kalpeshpatil33/Sumo_Robot/Report/First_Page.tex

\thispagestyle{empty}

\begin{center}

%\begin{figure}[h!]
%\begin{center}
%\includegraphics[scale=1]{uni_crest.png}
%\end{center}
%\end{figure}

\vspace*{.5cm}

\title{ \bfseries Sumo Robot \\ Report}
\author{Kalpesh Patil \\ Kanishke Gamagedara\\ {\normalsize kanishkegb@gwu.edu}\\{\normalsize Fall 2016}}

\vspace{10 mm}
 {\bf \color{MidnightBlue} {\Huge Sumo Robot } \vspace{4mm} \hline  \vspace{4mm} {\Huge Report}}\\

\vspace*{6cm}

{\large This is the project report for the robot ``Interpreter'' made for the class MAE 6194 }

\vspace*{5cm}

{\large Kalpesh Patil \\ {\normalsize kalpeshpatil33@gwu.edu }\\ \vspace*{5mm} Kanishke Gamagedara}\\ 
{\normalsize kanishkegb@gwu.edu}\\\vspace*{5mm}{\large Spring 2017}

\vspace*{3cm}

{\LARGE 
The George Washington University}

\end{center}
