kalpeshpatil33/Sumo_Robot/Report/structure.tex

%\usepackage{microtype}
%\usepackage[utf8]{inputenc}
%\usepackage[T1]{fontenc}
%\usepackage{titlesec}
%\usepackage{graphicx}
%\usepackage{enumitem}
%\usepackage{amsthm}
%%\setlist{nolistsep}
%\usepackage{tikz}
%\graphicspath{{images/}}
%
%\usepackage[utf8]{inputenc}
%\usepackage{amsmath}
%\usepackage{amsfonts}
%\usepackage{amssymb}
%\usepackage[left=2cm,right=2cm,top=2cm,bottom=2cm]{geometry}
%%\usepackage{color}
%\usepackage[usenames,dvipsnames]{xcolor}
%\usepackage{sectsty}
%\usepackage{framed}
%%\usepackage{tikz}
%
%% Font Settings
%\usepackage{avant}
%\usepackage{fourier} 
%\usepackage{charter}
%
%\theoremstyle{definition}
%\newtheorem{definition}{Definition}[section]
%\newtheorem{example}{Ex.}[section]
%\newtheorem{theorem}{Theorem}[section]
%

\usepackage{graphicx}
\graphicspath{{images/}} %image directory

\usepackage{amsmath}
\usepackage{amsfonts}
\usepackage{amssymb}
\usepackage{graphicx}
\usepackage{url}
\usepackage[top=25mm, bottom=25mm, left=30mm, right=25mm]{geometry}
\setlength{\parindent}{0cm} % first para - no indent
\usepackage{titlesec}
\usepackage{setspace}
\usepackage[nottoc]{tocbibind}
\usepackage{listings}
%\usepackage[table]{xcolor}
\usepackage{multirow}
\usepackage{pdflscape}
\usepackage{color}
\usepackage[usenames,dvipsnames]{xcolor}
\usepackage{fancyhdr}
\newtheorem{mydef}{Example}
\titlespacing*{\chapter}{0pt}{0pt}{20pt}
\usepackage{microtype}
\usepackage[toc,page]{appendix}

%\setlist{nolistsep}

% Font settings
\usepackage{avant}
\usepackage{fourier} 
\usepackage{charter}

% Header settings
%\titleformat{\chapter}{\Large\bfseries}{Chapter \thechapter }{14pt}{\Large}
%\titleformat{\chapter}{\Large\bfseries}{\thechapter }{14pt}{\Large}
\titleformat{\section}{\large\bfseries}{{\color{MidnightBlue}\thesection }}{13pt}{\color{MidnightBlue}\large}
\titleformat{\subsection}{\normalsize\bfseries}{ \color{NavyBlue}\thesubsection }{12pt}{\color{NavyBlue}\normalsize}
\titleformat{\paragraph}{\normalsize\bfseries}{ \thesection }{12pt}{\large}

% Itemize - remove exrea linespace
\newlength{\wideitemsep}
\setlength{\wideitemsep}{.5\itemsep}
\addtolength{\wideitemsep}{-7pt}
\let\olditem\item
\renewcommand{\item}{\setlength{\itemsep}{\wideitemsep}\olditem}

% Header and footer
\fancypagestyle{plain}{
\fancyhf{}
\renewcommand{\headrulewidth}{0pt}
\renewcommand{\footrulewidth}{0pt}
\fancyfoot[LE,RO]{\scriptsize{ \thepage} }
%\fancyfoot[RE,LO]{\small ODROID XU4 - Documentation}
%\fancyhead[RO,LE]{\scriptsize{FDCL Document}}
}

\definecolor{maroon}{RGB}{173,34,49}
\definecolor{shadecolor}{RGB}{233,244,255}
\definecolor{exframecolor}{RGB}{255,255,255}
\definecolor{exshadecolor}{RGB}{250,252,252}    

\newenvironment{exframe}{
\def\FrameCommand{\fboxrule=\FrameRule\fboxsep=\FrameSep \fcolorbox{exframecolor}{exshadecolor}}
\MakeFramed {\FrameRestore}}
{\endMakeFramed}

% For hyperlinks
\usepackage{hyperref}
\hypersetup{
    colorlinks,
    linkcolor={black!80!black},
    citecolor={blue!50!black},
    urlcolor={blue!80!black}
}

\usepackage{cleveref}  % automatic reference formatting (load AFTER hyperref)
\pagestyle{plain}
