kalpeshpatil33/Sumo_Robot/Report/images/placeholder.png

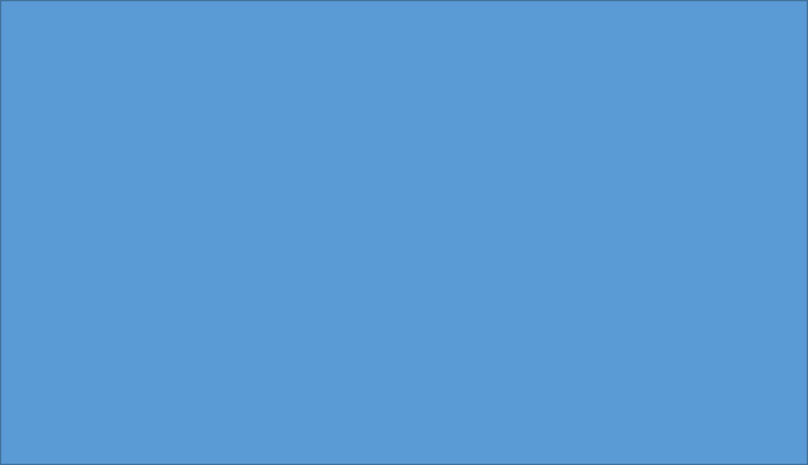
Report/images/placeholder.png
