kalpeshpatil33/Sumo_Robot/Report/images/structure.jpg

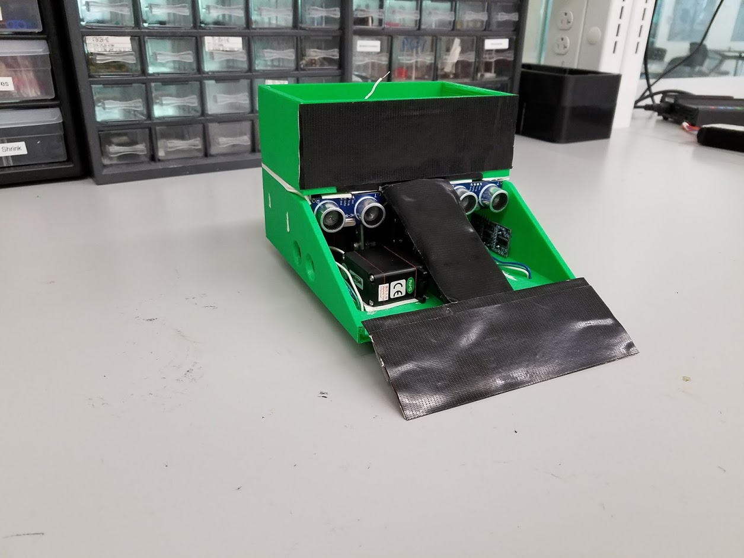
Report/images/structure.jpg
