kalpeshpatil33/Sumo_Robot/3dPrint/body.SLDPRT

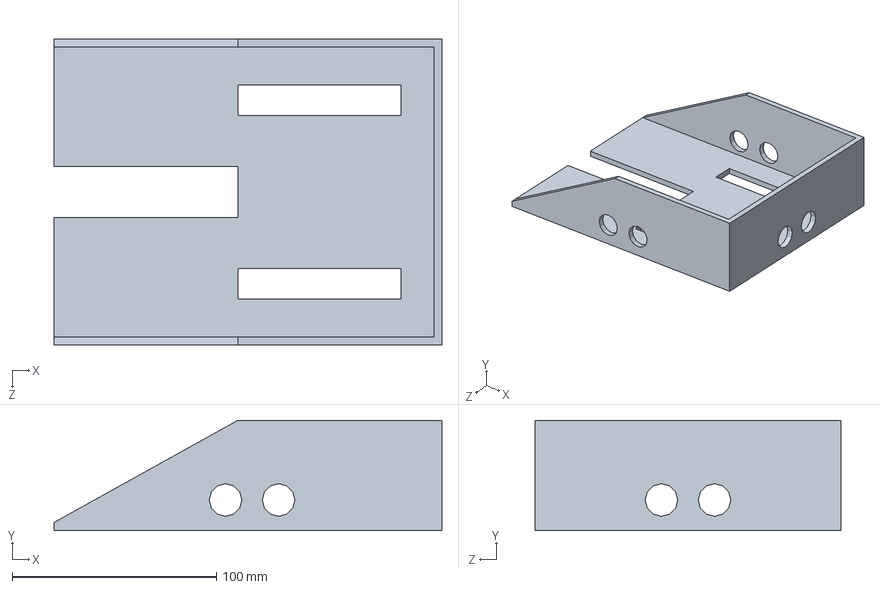
[picture p16: CAD file, 2017-04-25]
3dPrint/body.SLDPRT
190.0 x 54.0 x 150.0 mm
