kalpeshpatil33/Sumo_Robot/3dPrint/datapackage.SLDPRT

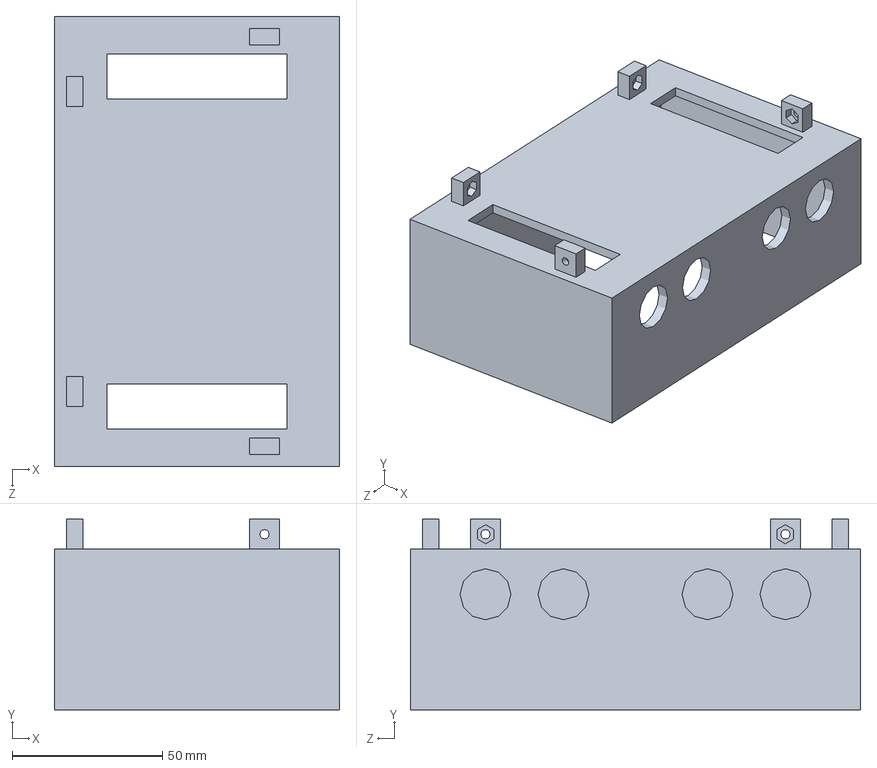
[picture p17: CAD file, 2017-04-25]
3dPrint/datapackage.SLDPRT
95.0 x 63.5 x 150.0 mm
