kalpeshpatil33/Sumo_Robot/3dPrint/cover.SLDPRT

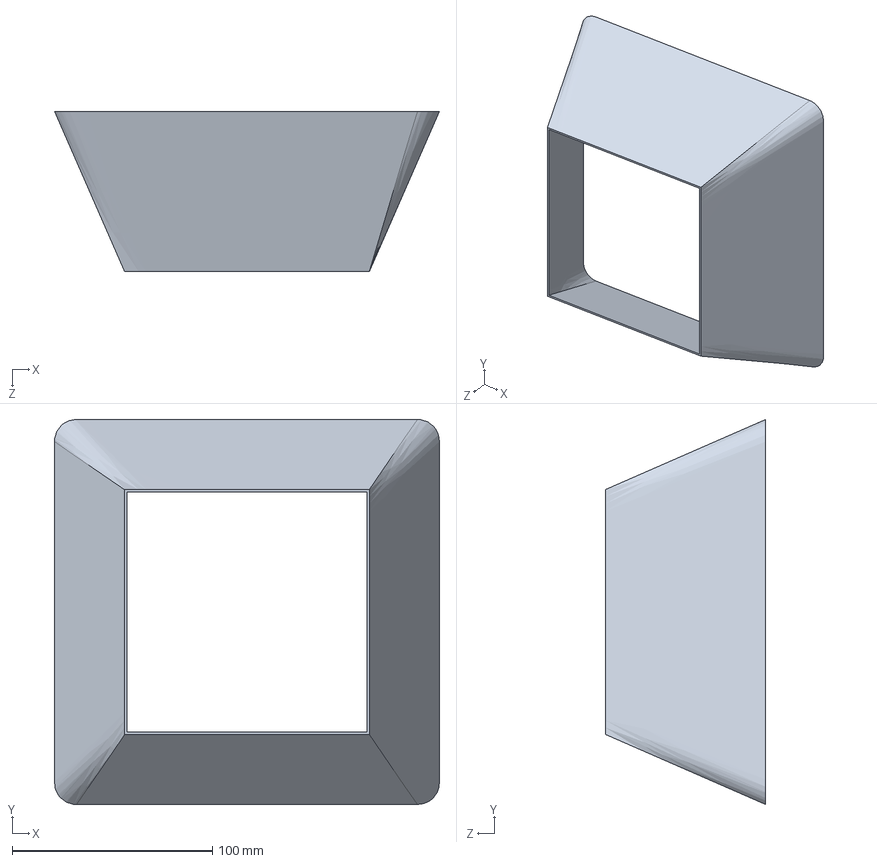
[picture p18: CAD file, 2017-04-17]
3dPrint/cover.SLDPRT
192.2 x 192.2 x 80.0 mm
