kalpeshpatil33/Sumo_Robot/3dPrint/Chassis.SLDPRT

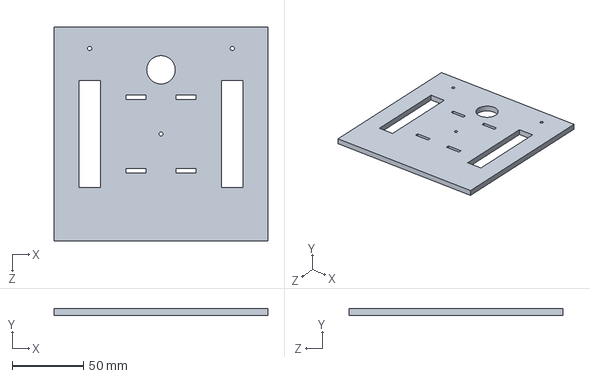
[picture p19: CAD file, 2017-04-05]
3dPrint/Chassis.SLDPRT
150.0 x 5.00 x 150.0 mm
