kalpeshpatil33/Sumo_Robot/(list of files, cad)

Other CAD files:
3dPrint/Chassis.STL
3dPrint/body.STL
3dPrint/datapackage.STL
