kalpeshpatil33/Sumo_Robot/Report/images/flowchart.pdf

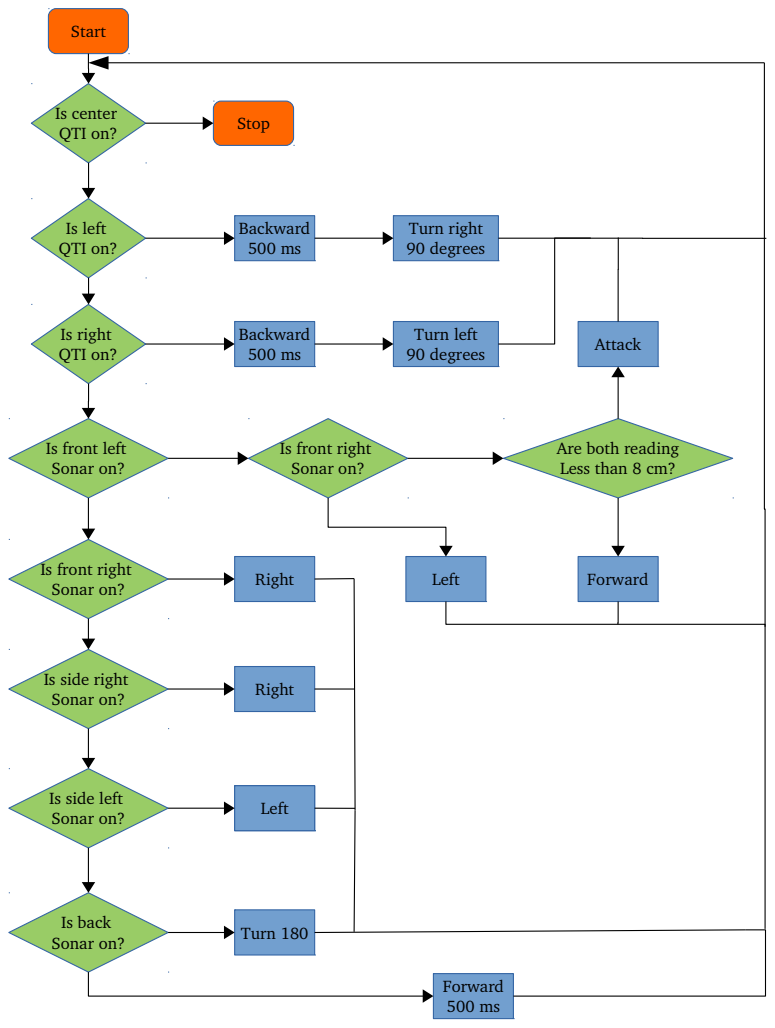
[picture p20: page 1]
Is center QTI on?; Start; Stop; Sonar on?; Right; Is back Sonar on?; Attack; Is left QTI on?; Is right QTI on?; Backward 500 ms; Turn right 90 degrees; Turn left 90 degrees; Left; Turn 180; Forward 500 ms

Is front left
Sonar on?

Is front right

Are both reading
Less than 8 cm?

Forward Is front right

Is side right

Is side left
