kalpeshpatil33/Sumo_Robot/mileStone_3/mileStone_3/mileStone_3.ino

int flag_Found;
int count = 0;
int left_count = 0;

//********** Wheels Variable **********
#include <Servo.h>
Servo myservo1;
Servo myservo2;
#define HCdistance 60

//********** QTI MIDDLE Variable **********
// BLACK == 1
volatile int MIDDLE_whiteLine;
int MIDDLE_sensorVal;
#define MIDDLE_pinQTIsensor 2

//********** QTI LEFT Variable **********
volatile int LEFT_whiteLine;
int LEFT_sensorVal;
#define LEFT_pinQTIsensor 21

//********** QTI RIGHT Variable **********
volatile int RIGHT_whiteLine;
int RIGHT_sensorVal;
#define RIGHT_pinQTIsensor 20

//********** HC-SR04 FRONT Variable **********
#define FRONT_trigPin 13
#define FRONT_echoPin 12
long FRONT_duration, FRONT_distance;

//********** HC-SR04 BACK Variable **********
#define BACK_trigPin 21
#define BACK_echoPin 22
long BACK_duration, BACK_distance;

//********** HC-SR04 LEFT Variable **********
#define LEFT_trigPin 21
#define LEFT_echoPin 22
long LEFT_duration, LEFT_distance;

//********** HC-SR04 RIGHT Variable **********
#define RIGHT_trigPin 21
#define RIGHT_echoPin 22
long RIGHT_duration, RIGHT_distance;


void goForward()
{
  digitalWrite(22, LOW);
  //Serial.println("Forward");
  myservo1.write(0);
  myservo2.write(190);
}

void goBackward()
{
  digitalWrite(22, LOW);
  //Serial.println("Backward");
  myservo1.write(190);
  myservo2.write(0);
}

void goLeft()
{
  digitalWrite(22, LOW);
  //Serial.println("Left");
  myservo1.write(0);
  myservo2.write(0);
}

void goRight()
{
  digitalWrite(22, LOW);
  //Serial.println("Right");
  myservo1.write(190);
  myservo2.write(190);
}

void goStop()
{
  digitalWrite(22, HIGH);
  //Serial.println("Stop");
  myservo1.write(95);
  myservo2.write(95);
}

void goU()
{
  //Serial.println("U");
  myservo1.write(0);
  myservo2.write(0);
}

void FRONT_HC()
{
  digitalWrite(FRONT_trigPin, LOW);
  digitalWrite(FRONT_trigPin, HIGH);
  delay(100);
  digitalWrite(FRONT_trigPin, LOW);
  FRONT_duration = pulseIn(FRONT_echoPin, HIGH);
  FRONT_distance = (FRONT_duration / 2) / 29.1;
}

void BACK_HC()
{
  digitalWrite(BACK_trigPin, LOW);
  digitalWrite(BACK_trigPin, HIGH);
  digitalWrite(BACK_trigPin, LOW);
  BACK_duration = pulseIn(BACK_echoPin, HIGH);
  BACK_distance = (BACK_duration / 2) / 29.1;
}

void LEFT_HC()
{
  digitalWrite(LEFT_trigPin, LOW);
  digitalWrite(LEFT_trigPin, HIGH);
  digitalWrite(LEFT_trigPin, LOW);
  LEFT_duration = pulseIn(LEFT_echoPin, HIGH);
  LEFT_distance = (LEFT_duration / 2) / 29.1;
}

void RIGHT_HC()
{
  digitalWrite(RIGHT_trigPin, LOW);
  digitalWrite(RIGHT_trigPin, HIGH);
  digitalWrite(RIGHT_trigPin, LOW);
  RIGHT_duration = pulseIn(RIGHT_echoPin, HIGH);
  RIGHT_distance = (RIGHT_duration / 2) / 29.1;
}

void searchBot ()
{
  //Serial.println("Searching");
  FRONT_HC();
  if (FRONT_distance < HCdistance && flag_Found == 0 )
  {
    //Serial.println("Front Detected");
    //Serial.println(FRONT_distance);
    goForward();
    flag_Found = 1;
  }
  //  BACK_HC();
  //  if (BACK_distance < 30 && flag_Found == 0 )
  //  {
  //    goU();
  //    delay(450);
  //    goStop();
  //    flag_Found = 1;
  //  }
  //  else
  //  {
  //    goStop();
  //  }
  //
  //  RIGHT_HC();
  //  if (RIGHT_distance < 30 && flag_Found == 0 )
  //  {
  //    goRight();
  //    delay(450);
  //    goStop();
  //    flag_Found = 1;
  //  }
  //  else
  //  {
  //    goStop();
  //  }
  //
  //  LEFT_HC();
  //  if (LEFT_distance < 30 && flag_Found == 0 )
  //  {
  //    goLeft();
  //    delay(450);
  //    goStop();
  //    flag_Found = 1;
  //  }
  //  else
  //  {
  //    goStop();
  //  }
}

void setup() {

  Serial.begin(115200);

  myservo1.attach(9);  // attaches the servo on pin 9 to the servo object
  myservo2.attach(8);

  pinMode(LEFT_pinQTIsensor, INPUT);
  digitalWrite(LEFT_pinQTIsensor, HIGH);

  pinMode(MIDDLE_pinQTIsensor, INPUT);
  digitalWrite(MIDDLE_pinQTIsensor, HIGH);

  pinMode(RIGHT_pinQTIsensor, INPUT);
  digitalWrite(RIGHT_pinQTIsensor, HIGH);

  attachInterrupt(digitalPinToInterrupt(MIDDLE_pinQTIsensor), MIDDLE_whiteLineISR, LOW);
  //  attachInterrupt(digitalPinToInterrupt(RIGHT_pinQTIsensor), RIGHT_whiteLineISR, LOW);
  //  attachInterrupt(digitalPinToInterrupt(LEFT_pinQTIsensor), LEFT_whiteLineISR, LOW);

  // we need to call this to enable interrupts
  interrupts();
  MIDDLE_whiteLine = 1;

  pinMode(FRONT_trigPin, OUTPUT);
  pinMode(FRONT_echoPin, INPUT);

  flag_Found = 0;

  //Serial.println("Initializing all sensors");
  delay(2000);
}

void MIDDLE_whiteLineISR() {
  goStop();
  //Serial.println(MIDDLE_sensorVal);
  //Serial.println("STOP Interrupt");
  MIDDLE_whiteLine = 0;
}

void RIGHT_whiteLineISR() {
  //  goLeft();
  //  goStop;
  //  goBackward();
  RIGHT_whiteLine = 1;
  //Serial.println("RIGHT Interrupt");
  //  MIDDLE_whiteLine = 1;
}

void LEFT_whiteLineISR() {
  //  goStop;
  //  goBackward();
  //  goRight();
  digitalWrite(22, LOW);
  //Serial.println("Backward");
  myservo1.write(190);
  myservo2.write(0);
  LEFT_whiteLine = 1;
  //Serial.println("LEFT Interrupt");
  //  MIDDLE_whiteLine = 1;
}


void loop()
{
  //Serial.println("Starts reading....");
  MIDDLE_sensorVal = digitalRead(MIDDLE_pinQTIsensor);
  LEFT_sensorVal = digitalRead(LEFT_pinQTIsensor);
  RIGHT_sensorVal = digitalRead(RIGHT_pinQTIsensor);
  //Serial.println("MIDDLE_sensorVal: " + String(MIDDLE_sensorVal));
  //Serial.println("LEFT_sensorVal: " + String(LEFT_sensorVal));
  //Serial.println("RIGHT_sensorVal: " + String(RIGHT_sensorVal));

  //  if (RIGHT_whiteLine == 1) {
  //    //Serial.println("Going back");
  //    //      goStop();
  //    goBackward();
  //    delay(200);
  //    RIGHT_whiteLine = 0;
  //  }
  //
  //  if (LEFT_whiteLine == 1) {
  //    //      goStop();
  //    //Serial.println("Going back");
  //    goBackward();
  //    delay(200);
  //    LEFT_whiteLine = 0;
  //  }
  if (MIDDLE_whiteLine == 1)
  {
    //Serial.println("No White Line");
    if (flag_Found == 0)
    {
      searchBot();
      delay(50);
      count ++;
    }
    if (count == 5)
    {
      goForward();
      delay(100);
      count = 0;
    }

    if (flag_Found == 0)
    {
      if (left_count > 5) {
        goForward();
        delay(20);
        left_count++;
        if (left_count > 9) {
         left_count = 0; 
        }
      }
      else {
        goLeft();
        delay(10);
        left_count++;
      }

    }
    flag_Found = 0;

    if (LEFT_sensorVal == 0 && RIGHT_sensorVal == 1 )
    {
      Serial.println("LEFT Interrupt loop");
      goStop();
      delay(10);
      goBackward();
      delay(1000);
      goRight();
      delay(1000);
      goForward();
      delay(500);
      MIDDLE_whiteLine = 1;
    }

    if (RIGHT_sensorVal == 0 && LEFT_sensorVal == 1)
    {
      Serial.println("RIGHT Interrupt loop");
      goStop();
      delay(10);
      goBackward();
      delay(1000);
      goLeft();
      delay(1000);
      goForward();
      delay(500);
      MIDDLE_whiteLine = 1;
    }

    if (RIGHT_sensorVal == 0 && LEFT_sensorVal == 0)
    {
      ////Serial.println("LEFT RIGHT Interrupt loop");
      goStop();
      delay(100);
      goU();
      delay(50);
      goStop();
      delay(100);
      goForward();
      delay(100);
    }
  }
}
