kalpeshpatil33/Sumo_Robot/test_HC-SR04/test_HC-SR04/test_HC-SR04.ino

#define trigPin 13
#define echoPin 12
long duration, distance;

void setup() {
  Serial.begin (9600);
  pinMode(trigPin, OUTPUT);
  pinMode(echoPin, INPUT);
}

void loop() {

  digitalWrite(trigPin, LOW); 
  digitalWrite(trigPin, HIGH);
delay(100);
  digitalWrite(trigPin, LOW);
  duration = pulseIn(echoPin, HIGH);
  distance = (duration / 2) / 29.1;
  Serial.println(String(duration) + "  " + String(distance));

}
