kalpeshpatil33/Sumo_Robot/(commit log)

2017-04-05 Chassis File Added
    [Chassis.SLDPRT]
2017-04-05 Final motorTest_QTI (Milestone_1)
2017-04-05 .thing file update
    [Chassis.STL]
2017-04-17 milestone_2 updated
    [cover.SLDPRT]
2017-04-20 milestone 3 started
    [body.SLDPRT, body.STL]
2017-04-25 milestone 3 updating
    [body.SLDPRT, datapackage.SLDPRT, datapackage.STL]
2017-05-07 sonars working with left right turns
2017-05-08 motors+qti working
2017-05-08 changed qti interrupts to flags
2017-05-08 before commneting out Serial.print
2017-05-08 replced print srtrings with int
